mpedromogollon-source/muebles/README.md

# Cálculo estructural: closet con maleteros sobre PTR de 30 x 30 mm

Modelo tridimensional de elementos finitos del closet de `datos/origen/closet_pedido_mx.skp`
con la modificación de dos PTR de 30 x 30 mm (3 x 3 cm) bajo los maleteros, apoyados en las torres.
Revisión 2: la primera versión suponía un PTR de 3" x 3"; esta la sustituye.

La memoria de cálculo completa está en
[`resultados/memoria_calculo_closet_PTR.pdf`](resultados/memoria_calculo_closet_PTR.pdf).

## Contenido

| Ruta | Qué hace |
|---|---|
| `datos/origen/` | Archivo SketchUp y diagrama de corte originales |
| `herramientas/skp_lector.py` | Lee el formato binario de SketchUp 2021+ y exporta las piezas visibles con sus medidas reales |
| `datos/piezas_closet.json` | Piezas del conjunto armado (coinciden con las 89 del diagrama de corte) |
| `modelo/parametros.py` | Materiales, cargas, rigideces y criterios adoptados |
| `modelo/perfiles.py` | Propiedades del PTR cuadrado por calibre |
| `modelo/modelo_fe.py` | Modelo OpenSeesPy: tableros como cascarones, PTR como vigas, uniones y contactos |
| `modelo/analisis.py` | Combinaciones de carga y posproceso |
| `modelo/ejecutar.py` | Corre todas las variantes y guarda `resultados/resultados.json` |
| `modelo/verificaciones.py` | Revisiones AISC 360-16 (PTR) y EN 1995 (tablero, uniones), volteo y anclaje |
| `modelo/pandeo.py` | Análisis con no linealidad geométrica (estabilidad) |
| `modelo/figuras.py`, `modelo/memoria.py` | Figuras y memoria en PDF |

## Cómo reproducir

```bash
pip install openseespy numpy matplotlib reportlab pillow
python herramientas/skp_lector.py datos/origen/closet_pedido_mx.skp --xmin 4700 --xmax 7800 \
    --salida datos/piezas_closet.json
python modelo/ejecutar.py          # ~15 min con 4 núcleos
python modelo/pandeo.py            # análisis no lineal, tarda bastante más
python modelo/verificaciones.py
python modelo/figuras.py
python modelo/memoria.py
```

`resultados/resultados.pkl` (campos de desplazamiento para figuras) no se versiona; lo
genera `ejecutar.py`.

## Resultado en breve

* El PTR de 30 x 30 mm trabaja como viga continua sobre los cuatro laterales de las torres. Con
  apoyos firmes necesitaría la mitad de su resistencia a flexión; el problema del proyecto es que
  uno de esos apoyos, el lateral interior de cada torre ("lateral aire"), no llega al piso
  (hueco de 205 mm) y cede porque cuelga de tornillos al tablero trasero.
* Tal como está diseñado, el mueble no cumple con ningún calibre (18, 16 o 14): la flecha del
  frente queda entre L/101 y L/110 a largo plazo, el tablero trasero de las torres y sus uniones
  se sobrecargan y los laterales exteriores se pandean con la carga sostenida.
* Solución recomendada: relleno de 15 mm (585 x 205 mm) bajo cada lateral aire, entrepaño fijo
  intermedio a 1120 mm en cada torre, suplemento de canto de 15 mm en la cara de cada lateral
  aire que da al hueco central, tubo cal. 14 fijado con pijas a cada 150 mm, maleteros unidos con
  tornillos pasantes M6 y anclaje al muro. La flecha del tramo central queda entre L/307 y L/322
  según la rigidez real de las pijas; el cal. 16 y el cal. 18 no la cumplen.
