mpedromogollon-source/muebles/(list of files, cad)

Other CAD files:
datos/origen/closet_pedido_mx.skp
