mpedromogollon-source/muebles/resultados/memoria_calculo_closet_PTR.pdf

Memoria de cálculo estructural. Closet con maleteros sobre PTR de 30 x 30 mm. Revisión 2 | Página 1

# Memoria de cálculo estructural

### Closet con tres maleteros apoyados en dos PTR de 30 x 30 mm sobre dos torres de melamina

Archivo de proyecto: closet pedido mx.skp (SketchUp 2023) y diagrama de corte del 15/08/2025. Fecha del cálculo: 12/10/2026. Revisión 2: el PTR es de 30 x 30 mm (3 x 3 cm); esta revisión sustituye a la anterior, que suponía un PTR de 3" x 3".

### Resumen ejecutivo

- El PTR de 30 x 30 mm trabaja como viga continua sobre los cuatro laterales de las torres (los exteriores y los

laterales aire). Con apoyos firmes necesitaría 0.19 kN·m, el 51% de su resistencia de 0.37 kN·m, y su flecha de servicio sería de unos 5 mm en el tramo central: la sección alcanza si los apoyos no ceden. Si el lateral aire no lo apoyara, como viga simple de 2865 mm necesitaría 1.01 kN·m (2.7 veces su resistencia). En el modelo, con la rigidez final de la melamina, el momento máximo del proyecto es 0.23 kN·m y la interacción con el axial llega al 66%.
- El proyecto tal cual no cumple. Flecha del PTR frontal 10.9 mm instantánea y 27.2 mm a largo plazo (L/106 en el

tramo exterior, límite L/300); tablero trasero de la torre con índice 1.58; uniones al 163% de su capacidad; tornillos entre maleteros al 128%; desplome sin anclaje de 13.8 mm instantáneo y 39.5 mm a largo plazo; y el lateral exterior se abomba 35 mm con la carga sostenida. Cambiar el calibre del tubo (18, 16 o 14) no lo resuelve: la flecha queda entre L/101 y L/110.
- La causa es el apoyo, no el tubo: el lateral interior de cada torre ("lateral aire", 900 mm) no llega al piso; entre la

cubierta de cajones y su canto inferior hay un hueco abierto de 205 mm. Ese lateral recibe la mayor parte de la carga del PTR frontal (0.61 kN en servicio, contra 0.37 kN del lateral exterior), cede porque cuelga de tornillos al tablero trasero y lo sobrecarga.
- Con un relleno de 15 mm (585 x 205 mm) bajo cada lateral aire, el lateral aire queda como apoyo firme y todas

las revisiones de resistencia cumplen: tableros al 55%, uniones al 44%, tubo cal. 16 al 42% aun sin acción conjunta con los maleteros (36% en cal. 14). La flecha del tramo central depende de cuánto cortante transmitan las pijas entre el tubo y los tableros. Con tubo cal. 14 y pijas a cada 150 mm cumple: L/307 con una rigidez baja de la pija, con la que todas las pijas quedan dentro de su capacidad (88%), y L/322 con la rigidez de EN 1995. Solo si la fijación no transmitiera nada quedaría en L/282, un 7% sobre el límite de apariencia. Con cal. 16 la flecha no cumple en ningún caso (L/252 a L/288).
- Estabilidad. El canto frontal de los laterales queda libre 870 mm en el compartimento superior. En el proyecto, con la

carga sostenida, el lateral exterior se abomba 35 mm. Solo con el relleno baja a 3.9 mm, todavía por encima del límite visual de 2.9 mm, y el lateral aire pierde rigidez cerca de λ = 1.4 a largo plazo. Con relleno y un entrepaño fijo intermedio a 1120 mm en cada torre queda en 1.3 mm; el abombamiento crece de forma moderada (al final de la corrida su pendiente es 1.5 a 1.6 veces la inicial, contra 3.5 o más sin entrepaño) y no hay pérdida de estabilidad hasta más de λ = 3.1 a largo plazo y 4 a corto plazo.
- El apoyo del tubo sobre los cantos de 15 mm queda al límite: 0.94 de la resistencia con relleno; si además se

omiten los tornillos entre maleteros llega a 1.005, ligeramente por encima de la resistencia. Un suplemento de canto de 15 mm atornillado a la cara de cada lateral aire que da al hueco central, a ras de su canto superior, lo baja a 0.50.
- Sin anclaje, el mueble vacío se voltea con una aceleración horizontal de 0.18 g y cargado con 0.21 g. Hay que fijarlo al

muro: 0.93 kN por torre y hasta 0.22 kN por taquete de maletero con el coeficiente adoptado. El anclaje también limita el desplome en servicio.
- Las repisas de 15 mm cumplen resistencia; con carga de almacenamiento sostenida su flecha diferida supera L/200.

Es un tema de apariencia que se corrige con un piso de maletero de 20 mm o más y un refuerzo frontal en los entrepaños de torre.

Memoria de cálculo estructural. Closet con maleteros sobre PTR de 30 x 30 mm. Revisión 2 | Página 2

### Resumen de verificaciones

Verificación | Proyecto | Con relleno | Relleno + entrepaño

Recomendada:
relleno +
entrepaño, cal.
14, pijas a 150
mm

Criterio

PTR: flexión con axial (AISC H1) | 0.66 | 0.40 | 0.40 | 0.36 | ≤ 1.0
PTR: cortante y paredes | 0.10 | 0.08 | 0.08 | 0.07 | ≤ 1.0

PTR frontal: flecha a largo plazo,
tramo que gobierna | L/106 | L/306 | L/305 | L/307 | ≤ L/300
Apoyo del PTR en canto de 15 mm σ/fc,d | 0.67 | 0.94 | 0.94 | 0.93 | ≤ 1.0

Apoyo con suplemento de canto en el
lateral aire | 0.47 | 0.47 | 0.47 | 0.47 | ≤ 1.0
Tableros: índice de esfuerzo máximo | 1.58 | 0.55 | 0.55 | 0.52 | ≤ 1.0
Uniones: demanda / confirmat típicos | 1.63 | 0.44 | 0.44 | 0.44 | ≤ 1.0
Tornillos entre maleteros | 1.28 | 0.49 | 0.49 | 0.51 | ≤ 1.0
Estabilidad, corto plazo: λ límite | > 3.156 | > 2.031 | > 4.0 | > 4.0 | ≥ 3
Estabilidad, largo plazo: λ límite | > 1.75 | > 1.406 | > 3.125 | > 3.125 | ≥ 3

Abombamiento de laterales con carga

sostenida | 34.7 mm | 3.9 mm | 1.3 mm | 1.3 mm | ≤ 870/300 = 2.9
| | | | | mm

Desplome superior de maleteros a

largo plazo, sin anclaje | 39.5 mm | 10.6 mm | 10.6 mm | 10.9 mm | < 5 mm (se
| | | | | resuelve con el
| | | | | anclaje)
Repisas: flecha diferida / (L/200) | 4.27 | 2.36 | 2.36 | 2.36 | ≤ 1.0

Volteo sin anclaje: aceleración que lo
inicia | 0.18 g | 0.18 g | 0.18 g | 0.18 g | anclar al muro

Verde: cumple con holgura. Amarillo: al límite o requiere atención. Rojo: no cumple. Tubo cal. 16 y fijación rígida del PTR salvo indicación; la fijación rígida es una idealización que las pijas no alcanzan (sección 6.6). "-" indica caso no analizado. La estabilidad de la solución recomendada se toma de la variante con relleno y entrepaño.

Memoria de cálculo estructural. Closet con maleteros sobre PTR de 30 x 30 mm. Revisión 2 | Página 3

## 1. Objeto y alcance

Se verifica la estructura del closet con la modificación indicada por el cliente: dos PTR de 30 x 30 mm colocados bajo los maleteros, a todo lo largo, apoyados sobre las dos torres (módulos verticales). Se revisan el PTR, los tableros de melamina, las uniones atornilladas, el apoyo del PTR sobre los cantos de los tableros, la estabilidad de los laterales, las deformaciones y el volteo. El cálculo se hace con un modelo tridimensional de elementos finitos construido a partir de la geometría real del archivo SketchUp, complementado con verificaciones analíticas.

## 2. Descripción del mueble

La geometría se extrajo directamente del archivo .skp (formato SketchUp 2023, árbol binario de componentes) con un lector propio. Las 89 piezas de melamina de 15 mm extraídas coinciden una a una con el diagrama de corte (22.41 m² de tablero, 6 hojas de 2440 x 1830 mm). Medidas principales:

Elemento | Medidas (mm) | Composición
Conjunto | 2880 de frente x 600 de fondo; altura 2440 en
el proyecto, 2470 con los PTR bajo maleteros

Dos torres en los extremos, hueco central de 1640 mm, tres maleteros arriba

Torre (x2) | 620 x 600 x 1570 (zócalo 100 + casco 1470)

Lateral exterior 1455, trasero 15 mm de 605 x 1455, piso, 2 cajones, cubierta 605 x 585 a 450, entrepaño con amarres a 685, travesaños superiores 590 x 100, puerta 618 x 897

Lado interior de torre Panel inferior 585 x 335 (z 115 a 450); lateral aire 585 x 900 (z 670 a 1570)

Hueco abierto de 205 mm entre z 465 y 670: el lateral aire no tiene apoyo directo hacia el piso

Maletero (x3) | 960 x 870 x 600

Costados de altura completa, piso y techo entre costados, dos tiras traseras de 200 mm, travesaño frontal 930 x 100, dos puertas 478 x 855

PTR (x2) | 30 x 30, L = 2880 | Uno a paño frontal y otro a paño trasero, bajo los costados y el piso
de los maleteros, apoyados en la parte superior de las torres

Nombres usados en este documento y su correspondencia con el diagrama de corte (letras de pieza y nombre de componente en SketchUp):

Nombre en la memoria | Letras en el diagrama de corte | Componente SketchUp
Lateral exterior | C, D | ESPCL-LD-02
Lateral aire | H, I | lateral aire
Trasero 15 mm | A, B | fondo 15mm
Piso de torre | Q, R | ESPCL-PI-02
Travesaño superior de torre | AC, AD | ESPCL-T-01
Panel inferior interior | AI, AJ | REPIZA@1#8
Cubierta de cajones | W, X | REPIZA@1#9
Travesaño bajo cubierta | AA, AB | REPIZA@1#7
Entrepaño (tope) | Y, Z | PTRSOP024-TO
Amarre trasero bajo entrepaño | AF, AH | PTRSOP022
Amarre frontal bajo entrepaño | AE, AG | PTRSOP0-125
Zócalo frontal | S, T | ZOCALO-ALANTE-02
Zócalo trasero | U, V | ZOCALO-ATRAS-01
Zócalo lateral | AU, AV | ZOCALO-DE-03
Zócalo lateral | AW, AX | ZOCALO-IZ-04
Piso de maletero | E | MALEST-MA
Techo de maletero | F | MALEST-MR
Costado de maletero | M | MALEST-MI
Costado de maletero | L | MALEST-MD
Tira trasera de maletero | P | MALEST-RI
Tira trasera de maletero | O | MALEST-RD

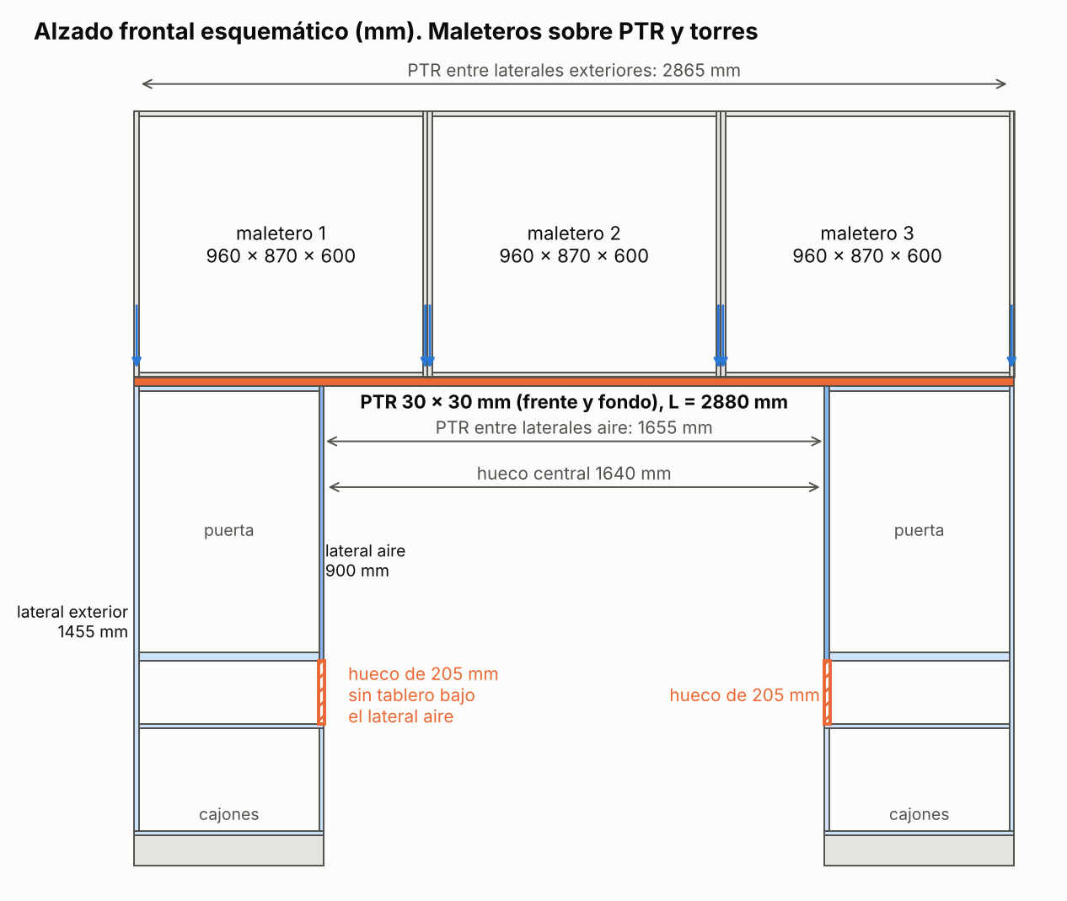
[picture p1: figure]

Memoria de cálculo estructural. Closet con maleteros sobre PTR de 30 x 30 mm. Revisión 2 | Página 4
Nombre en la memoria | Letras en el diagrama de corte | Componente SketchUp
Travesaño frontal de maletero | G | REPIZA@1#1
Relleno propuesto | nuevo | relleno bajo lateral aire

Figura 1. Alzado frontal esquemático. En naranja rayado, el hueco de 205 mm bajo cada lateral aire.

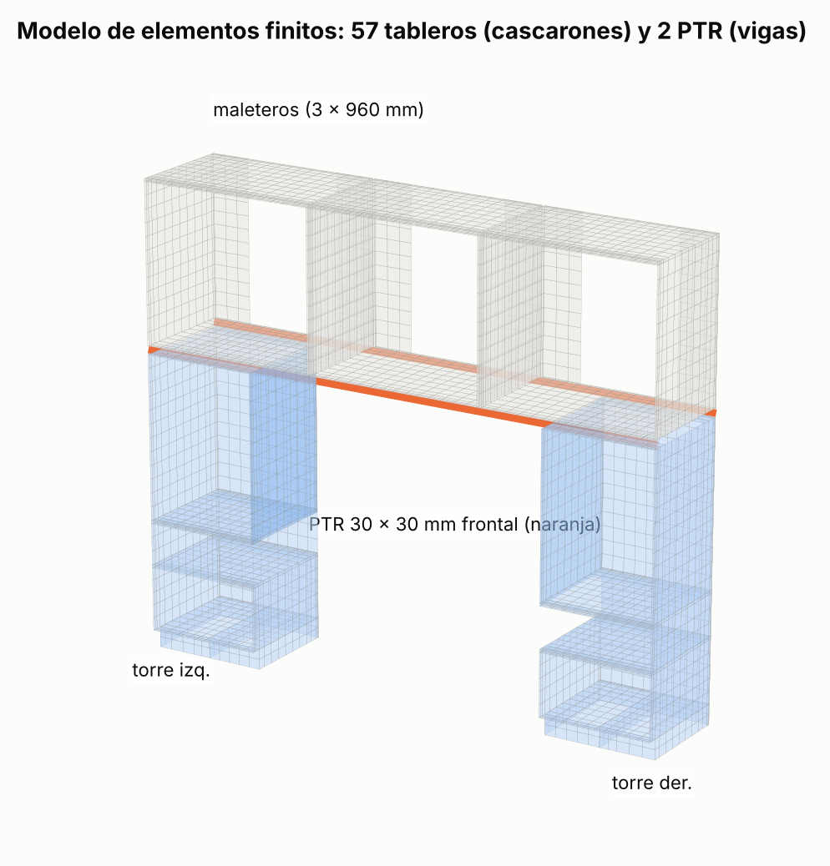
[picture p2: figure]

Memoria de cálculo estructural. Closet con maleteros sobre PTR de 30 x 30 mm. Revisión 2 | Página 5

Figura 2. Modelo de elementos finitos (tableros en su plano medio; PTR en naranja).

## 3. Materiales y propiedades adoptadas

La melamina comercial es tablero de partículas de uso interior (tipo EN 312 P2), que no es un grado estructural. Se adoptaron valores reducidos a partir de EN 12369-1 (P4, 13 a 20 mm) escalados al mínimo de P2 y los factores de duración de carga y fluencia de EN 1995-1-1 para tablero de partículas en clase de servicio 1.

Propiedad | Valor | Fuente o criterio
Tablero: espesor, densidad | 15 mm, 680 kg/m³ | Diagrama de corte; densidad típica de MDP
Módulo de elasticidad medio E, ν | 2000 MPa, 0.25 | Mínimo P2 (1600) llevado a valor medio

f

m,k / ft,k / fc,k / fv,k | 10.0 / 6.5 / 8.5 / 4.8 MPa | EN 12369-1 P4 escalado a P2

k

mod permanente / largo plazo / corto | 0.3 / 0.45 / 0.85 | EN 1995-1-1 tabla 3.1

k

def, γM | 2.25, 1.3 | EN 1995-1-1 tablas 3.2 y 2.3
Acero PTR: E, F y | 200000 MPa, 250 MPa | F y conservador; un ASTM A500 Gr. B tiene 317 MPa
PTR de 30 x 30 mm cal. 18 | t = 1.21 mm nominal, 1.13 mm de diseño; A = 1.27 cm²; I = 1.74 cm⁴; Z = 1.36 cm³; 1.07 kg/m | Espesor de diseño 0.93 t (AISC B4.2); radio exterior 2t

Memoria de cálculo estructural. Closet con maleteros sobre PTR de 30 x 30 mm. Revisión 2 | Página 6
Propiedad | Valor | Fuente o criterio
PTR de 30 x 30 mm cal. 16 | t = 1.52 mm nominal, 1.41 mm de diseño; A = 1.56 cm²; I = 2.09 cm⁴; Z = 1.66 cm³; 1.31 kg/m | Espesor de diseño 0.93 t (AISC B4.2); radio exterior 2t (caso base)

PTR de 30 x 30 mm cal. 14

t = 1.90 mm nominal, 1.76 mm de diseño; A = 1.91 cm²; I = 2.49 cm⁴; Z = 1.99 cm³; 1.60 kg/m

Espesor de diseño 0.93 t (AISC B4.2); radio exterior 2t

Confirmat 7 x 50 en melamina 15 mm | F

v,k = 1.0 kN; Fax,k = 0.8 kN

Valores adoptados, verificar con el fabricante. Se usan para la tracción de los tornillos de unión entre maleteros

Tornillo pasante M6 entre dos tableros de
15 mm | F
v,d = 314 N por plano | EN 1995-1-1 8.2.2 (Johansen), kmod = 0.45

Pija de 4.8 mm a través de la pared del
tubo en 15 mm de tablero | F

v,d = 283 N; K
ser
= 7401 N/mm | EN 1995-1-1 8.2.3 (placa de acero delgada) y
7.1 (acero contra tablero)

## 4. Cargas y combinaciones

Caso | Descripción | Valor
G | Peso propio de tableros (+5 % por cubrecanto y herrajes), puertas, cajones,
| correderas y PTR | 2.51 kN en total (256 kg)
Q maleteros | Contenido sobre el piso de cada maletero | 1.5 kN/m² (150 kg/m²)
Q torres | Cubierta de cajones y entrepaño; contenido de cajones | 1.5 kN/m²; 25 kg por cajón
Q barra | Barra de colgar supuesta en el hueco central, fijada a los laterales aire a 1450
| mm | 0.40 kN/m sobre 1.64 m
H | Fuerza horizontal hacia el frente para dimensionar anclajes | 0.5 (G + ψ2 Q)

Carga total en servicio G + Q = 8.82 kN. Combinaciones: para el acero, AISC 360-16 con ASCE 7 (1.2G + 1.6Q y 1.4G). Para tableros y uniones, EN 1990 (1.35G + 1.5Q con kmod de largo plazo y 1.35G con kmod permanente). Servicio: G + Q instantánea y G + ψ2
Q con ψ2

= 0.8 (almacenamiento) para la deformación diferida, calculada con E/(1 + kdef) en los tableros, con la rigidez de las uniones entre tableros dividida entre 1 + 2kdef (EN 1995-1-1 2.3.2.2, materiales con la misma fluencia) y la de las pijas acero contra tablero entre 1 + kdef. Anclaje: G + ψ2

Q + H.

## 5. Modelo de elementos finitos

El modelo se construyó en OpenSeesPy. Las decisiones de idealización son las siguientes:
- Cada tablero es un cascarón ShellMITC4 en su plano medio (5854 elementos de hasta 75 mm). Los cantos que llegan

a otro tablero se llevan al plano medio de éste.
- Cada tablero tiene nodos propios. Las uniones son resortes en traslación sin momento (bisagra lineal): 10 N/mm por

mm de unión en corte y tracción (tornillería), y 150 N/mm por mm en compresión cuando un canto apoya directamente en una cara. Son 966 resortes de canto y 683 de cara (entrepaños sobre amarres y travesaños, y 4 tornillos entre maleteros contiguos).
- Los PTR de 30 x 30 mm son vigas elásticas 3D en su eje; los maleteros se elevan 30 mm. El contacto vertical con

torres y maleteros es solo a compresión (el mueble descansa sobre el PTR); en horizontal la fijación se supone rígida, y en la sección 6.6 se repite con pijas de rigidez realista. Se resuelve por Newton para cada combinación.
- Base del zócalo articulada en el piso. Puertas y cajones se aplican como cargas en el tablero que los soporta (bisagras

del lado del lateral aire en las torres).
- Controles: el peso del modelo coincide con el del despiece; las reacciones igualan la carga aplicada; los resultados son

simétricos entre torres; no quedan contactos en tracción.

Variantes analizadas, cada una a corto y largo plazo: proyecto con tubo cal. 18, 16 y 14; proyecto sin tornillos entre maleteros; relleno de 15 mm bajo cada lateral aire, con y sin tornillos entre maleteros; relleno más un entrepaño fijo intermedio a 1120 mm en cada torre, con tubo cal. 16 y cal. 18 y fijación rígida, y con fijación por pijas en cal. 16 y cal. 14 (rigidez de EN 1995 a cada 150 y 75 mm, y una rigidez menor a cada 150 mm como sensibilidad); y, como referencia, el proyecto con PTR de 3" x 3". Las variantes principales se revisan en estado último también con la rigidez final de la

Memoria de cálculo estructural. Closet con maleteros sobre PTR de 30 x 30 mm. Revisión 2 | Página 7

melamina, y se toma la envolvente. Además uniones diez veces más rígidas (sensibilidad, sección 6.1) y caso horizontal con anclajes al muro.

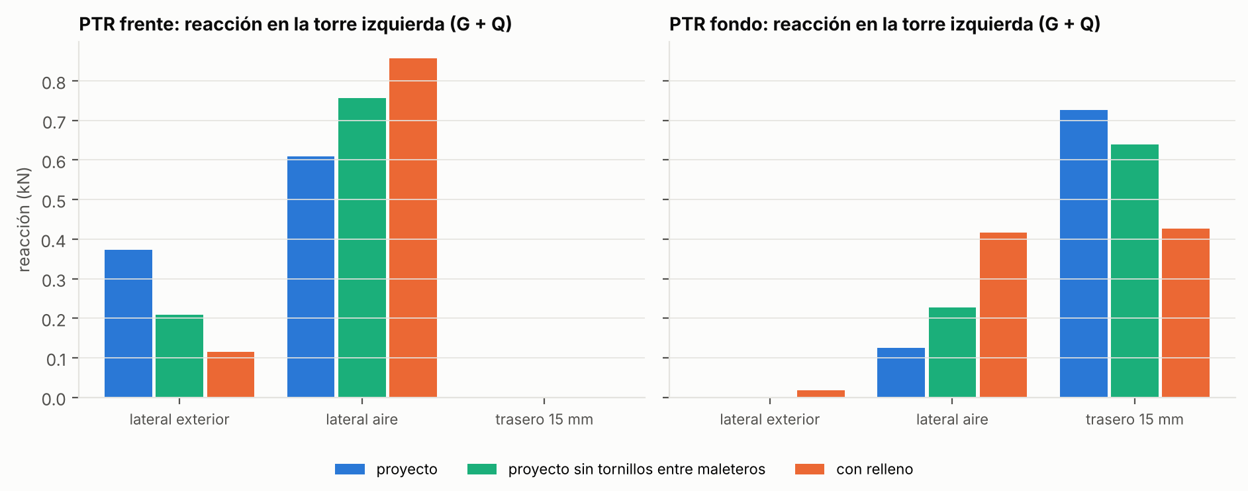
[picture p3: figure]

Memoria de cálculo estructural. Closet con maleteros sobre PTR de 30 x 30 mm. Revisión 2 | Página 8

## 6. Resultados

### 6.1 Cómo trabaja el conjunto y cómo llega la carga a las torres

El tubo de 30 x 30 mm se apoya en los cuatro laterales de las torres y comparte la carga con los maleteros, que son más rígidos que él y están fijados a él. Lo que decide el comportamiento es la rigidez de los apoyos. La figura 3 y la tabla muestran qué elemento de la torre recibe la reacción de cada PTR. En el proyecto, el lateral aire recibe la mayor parte del frente aunque no llega al piso; la pasa por tornillos al tablero trasero y por eso cede. El PTR trasero se apoya sobre todo en el canto del tablero trasero de 15 mm, que trabaja como muro. Con uniones diez veces más rígidas el reparto del PTR frontal apenas cambia (el lateral aire recibe 0.63 kN en lugar de 0.61 kN), pero el del trasero sí: el lateral aire pasa de 0.13 a 0.38 kN y el tablero trasero de 0.73 a 0.48 kN.

Figura 3. Reacción de cada PTR sobre los elementos de la torre izquierda (la derecha es simétrica), combinación G + Q.

PTR / elemento de la torre | Proyecto (kN) | Con relleno (kN) | Relleno + entrepaño (kN) | Proyecto sin tornillos entre maleteros (kN)
PTR frente: lateral exterior | 0.37 | 0.12 | 0.12 | 0.21
PTR frente: lateral aire | 0.61 | 0.86 | 0.86 | 0.76
PTR fondo: lateral exterior | 0.00 | 0.02 | 0.02 | 0.00
PTR fondo: lateral aire | 0.13 | 0.42 | 0.42 | 0.23
PTR fondo: trasero 15 mm | 0.73 | 0.43 | 0.43 | 0.64

### 6.2 PTR de 30 x 30 mm

Sección compacta en los tres calibres (b/t = 18.2 en cal. 16, λ
p

= 31.7). Resistencias de diseño AISC 360-16 (F7, G4 y J10) con espesor de diseño 0.93 t; como no se conoce el radio de esquina se usan b = h = B - 3t y k = 1.5t. La revisión de paredes compara la reacción del lateral exterior con la resistencia de extremo y la del lateral aire con la interior. Como el reparto de cargas entre el tubo y la melamina depende de la rigidez, la flexión se revisa con la rigidez instantánea y con la final, E/(1 + ψ2

k

def), según EN 1995-1-1 2.3.2.2; la tabla da la que gobierna. La fijación a los tableros induce un axial en el tubo, que se combina con la flexión según AISC H1-1; como el tubo está fijado a cada 150 mm o menos, su esbeltez a compresión es despreciable y P
c

= 0.9F
y

A.

Comprobación manual con la carga que los maleteros apoyan en el PTR frontal (2.83 kN en 1.2G + 1.6Q y 1.93 kN en G + Q), repartida a lo largo del tubo. Como viga continua sobre los cuatro laterales con apoyos firmes: Mu

= 0.19 kN·m y
flecha de servicio de 5.1 mm en el tramo central. Como viga simple de 2865 mm, si el lateral aire no apoyara: Mu

= WL/8 =
1.01 kN·m y 5WL³/384EI = 141 mm. El modelo con fijación rígida da 0.12 kN·m con rigidez instantánea: menos que la viga continua porque los maleteros, más rígidos que el tubo y fijados a él, toman parte de la carga. En el proyecto la flecha del modelo (10.9 mm respecto a los laterales exteriores) es mucho mayor que la de la viga continua porque el lateral aire cede: es un apoyo flexible.

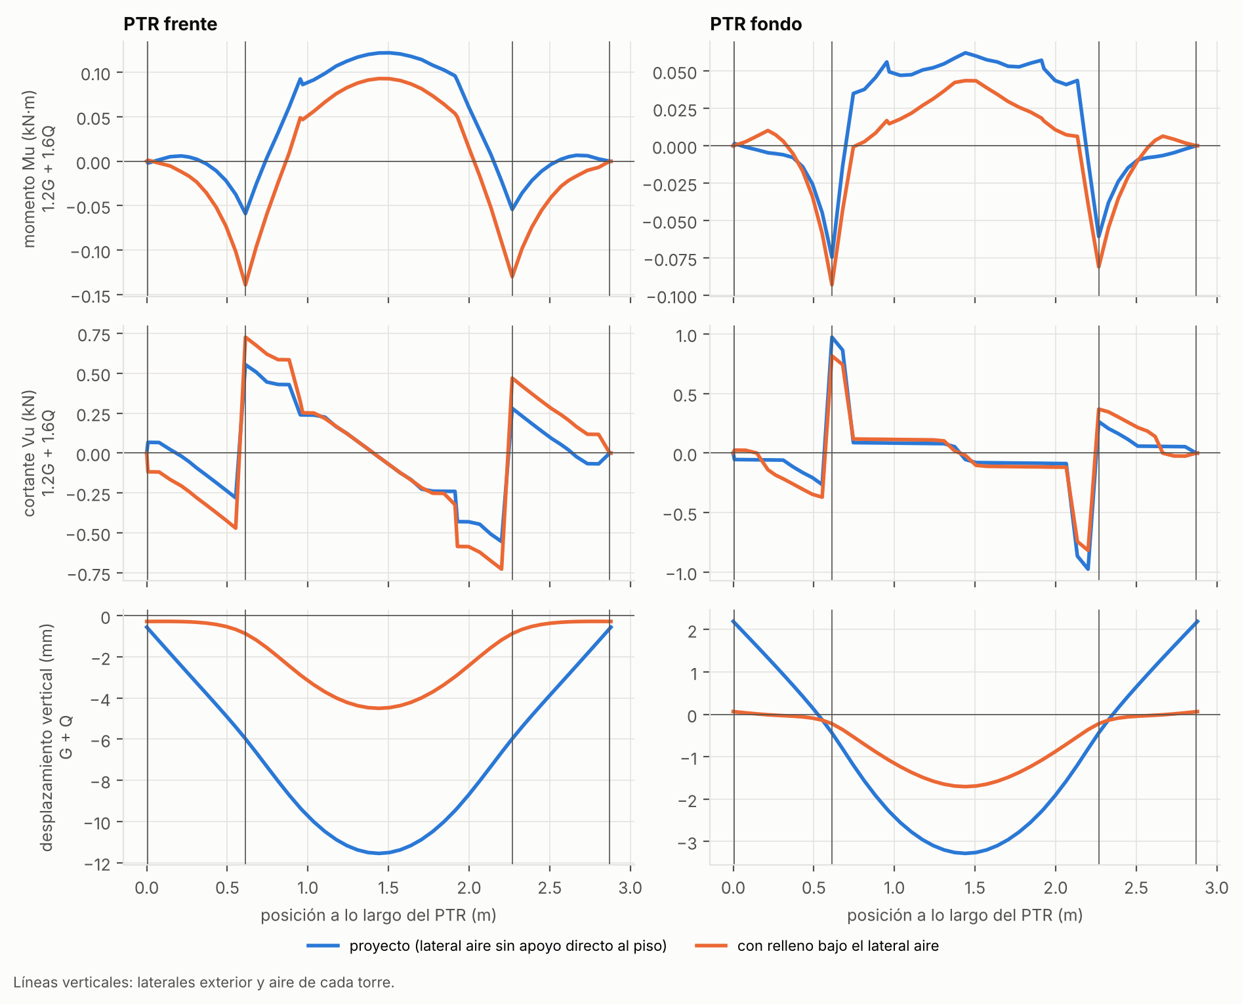
[picture p4: figure]

Memoria de cálculo estructural. Closet con maleteros sobre PTR de 30 x 30 mm. Revisión 2 | Página 9

Figura 4. Momento y cortante últimos (1.2G + 1.6Q, rigidez instantánea) y desplazamiento en servicio (G + Q) a lo largo de cada PTR.

Variante | Perfil | φMn
| | (kN·m) | Flexión con
| | | axial, H1
| | | (rigidez) | V
| | | | u /φV
n
| | | | | Flecha
| | | | | G+Q
| | | | | (mm) | Flecha
| | | | | | largo plazo
| | | | | | (mm) | Relación
| | | | | | | (tramo)
Proyecto | 30x30 cal. 16 | 0.37 | 0.66 (final) | 0.10 | 10.9 | 27.2 | L/106 (exterior)
Proyecto, cal. 18 | 30x30 cal. 18 | 0.31 | 0.72 (final) | 0.12 | 11.4 | 28.3 | L/101 (exterior)
Proyecto, cal. 14 | 30x30 cal. 14 | 0.45 | 0.60 (final) | 0.08 | 10.6 | 26.1 | L/110 (exterior)

Proyecto sin tornillos entre
maleteros | 30x30 cal. 16 | 0.37 | 0.77 (final) | 0.08 | 13.3 | 32.0 | L/89 (exterior)
Con relleno | 30x30 cal. 16 | 0.37 | 0.40
| | | (instantánea) | 0.08 | 3.6 | 5.4 | L/306 (central)

Con relleno, sin tornillos entre

maleteros | 30x30 cal. 16 | 0.37 | 0.43
| | | (instantánea) | 0.08 | 3.9 | 5.7 | L/290 (central)
Relleno + entrepaño | 30x30 cal. 16 | 0.37 | 0.40
| | | (instantánea) | 0.08 | 3.6 | 5.4 | L/305 (central)
Relleno + entrepaño, cal. 18 | 30x30 cal. 18 | 0.31 | 0.49 (final) | 0.10 | 4.0 | 6.1 | L/273 (central)

Relleno + entrepaño, cal. 16,

sin acción conjunta | 30x30 cal. 16 | 0.37 | 0.42
(instantánea) | 0.08 | 5.0 | 6.6 | L/252 (central)

Relleno + entrepaño, cal. 16,

pijas a 150 mm, rigidez baja | 30x30 cal. 16 | 0.37 | 0.42
(instantánea) | 0.08 | 4.4 | 6.0 | L/274 (central)

Relleno + entrepaño, cal. 16,
pijas a 150 mm, rigidez EN
1995
30x30 cal. 16 | 0.37 | 0.41
(instantánea) | 0.08 | 4.0 | 5.7 | L/288 (central)

Memoria de cálculo estructural. Closet con maleteros sobre PTR de 30 x 30 mm. Revisión 2 | Página 10
Variante | Perfil | φMn (kN·m)

Flexión con
axial, H1
(rigidez)

V
u

/φV
n

Flecha
G+Q
(mm)

Flecha
largo plazo
(mm)

Relación
(tramo)

Relleno + entrepaño, cal. 14,

sin acción conjunta | 30x30 cal. 14 | 0.45 | 0.36
| | (instantánea) | 0.07 | 4.4 | 5.9 | L/282 (central)

Recomendada: relleno +
entrepaño, cal. 14, pijas a 150
mm
30x30 cal. 14 | 0.45 | 0.36 (final) | 0.07 | 3.9 | 5.4 | L/307 (central)

Relleno + entrepaño, cal. 14, pijas a 150 mm, rigidez EN 1995

30x30 cal. 14 | 0.45 | 0.35
| | (instantánea) | 0.07 | 3.6 | 5.1 | L/322 (central)

Proyecto, PTR de 3" x 3" (76.2

mm), comparación | 3"x3" cal. 14 | 2.78 | 0.25
(instantánea) | 0.03 | 4.1 | 5.4 | L/529 (exterior)

Flecha del PTR frontal respecto a dos cuerdas: entre laterales exteriores (L = 2865 mm, límite 9.6 mm) y entre laterales aire (tramo central, L = 1655 mm, límite 5.5 mm); se informa la que gobierna. El PTR de 3" x 3" se incluye solo como comparación con la revisión anterior.

### 6.3 Deformaciones

Elemento | Variante | Instantánea
| | G+Q (mm) | Largo plazo
| | | (mm) | Límite (mm) | Relación
PTR frente, tramo exterior (L = 2865 mm) | Proyecto | 10.94 | 27.16 | 9.6 (L/300) | L/106
PTR frente, tramo central (L = 1655 mm) | Proyecto | 5.57 | 11.68 | 5.5 (L/300) | L/142
PTR fondo, tramo exterior (L = 2865 mm) | Proyecto | 5.44 | 10.81 | 9.6 (L/300) | L/265
PTR fondo, tramo central (L = 1655 mm) | Proyecto | 2.84 | 5.22 | 5.5 (L/300) | L/317
PTR frente, tramo exterior (L = 2865 mm) | Con relleno | 4.22 | 7.79 | 9.6 (L/300) | L/368
PTR frente, tramo central (L = 1655 mm) | Con relleno | 3.63 | 5.42 | 5.5 (L/300) | L/306
PTR fondo, tramo exterior (L = 2865 mm) | Con relleno | 1.77 | 3.57 | 9.6 (L/300) | L/804
PTR fondo, tramo central (L = 1655 mm) | Con relleno | 1.49 | 2.57 | 5.5 (L/300) | L/644
PTR frente, tramo exterior (L = 2865 mm) | Relleno + entrepaño | 4.23 | 7.81 | 9.6 (L/300) | L/367
PTR frente, tramo central (L = 1655 mm) | Relleno + entrepaño | 3.63 | 5.42 | 5.5 (L/300) | L/305
PTR fondo, tramo exterior (L = 2865 mm) | Relleno + entrepaño | 1.77 | 3.57 | 9.6 (L/300) | L/803
PTR fondo, tramo central (L = 1655 mm) | Relleno + entrepaño | 1.49 | 2.57 | 5.5 (L/300) | L/643
PTR frente, tramo exterior (L = 2865 mm) | Recomendada: relleno +
| entrepaño, cal. 14, pijas
| a 150 mm | 4.58 | 8.01 | 9.6 (L/300) | L/358

PTR frente, tramo central (L = 1655 mm)

Recomendada: relleno +
entrepaño, cal. 14, pijas
a 150 mm
3.92 | 5.39 | 5.5 (L/300) | L/307

PTR fondo, tramo exterior (L = 2865 mm)

Recomendada: relleno +
entrepaño, cal. 14, pijas
a 150 mm
2.02 | 3.70 | 9.6 (L/300) | L/774

PTR fondo, tramo central (L = 1655 mm)

Recomendada: relleno +
entrepaño, cal. 14, pijas
a 150 mm
| | 1.73 | 2.71 | 5.5 (L/300) | L/611
Entrepaño (tope) (L = 605) | Proyecto | 4.36 | 12.90 | 3.0 (L/200) | L/47
Piso de maletero (maletero 2) (L = 570) | Proyecto | 2.16 | 6.53 | 2.9 (L/200) | L/87
Cubierta de cajones (L = 605) | Proyecto | 1.73 | 5.64 | 3.0 (L/200) | L/107
Piso de maletero (maletero 2) (L = 570) | Con relleno | 2.28 | 6.74 | 2.9 (L/200) | L/85
Entrepaño (tope) (L = 605) | Con relleno | 1.75 | 6.02 | 3.0 (L/200) | L/100
Cubierta de cajones (L = 605) | Con relleno | 1.68 | 5.43 | 3.0 (L/200) | L/111
Desplome hacia el frente en la parte alta de los maleteros, sin anclaje al muro: 13.8 mm instantáneo en el proyecto y 3.9 mm con relleno; con la fluencia llega a 39.5 y 10.6 mm. Proviene de que el frente baja más que el fondo y gira los maleteros; el anclaje superior al muro lo restringe, así que es necesario también en servicio. En el proyecto la flecha

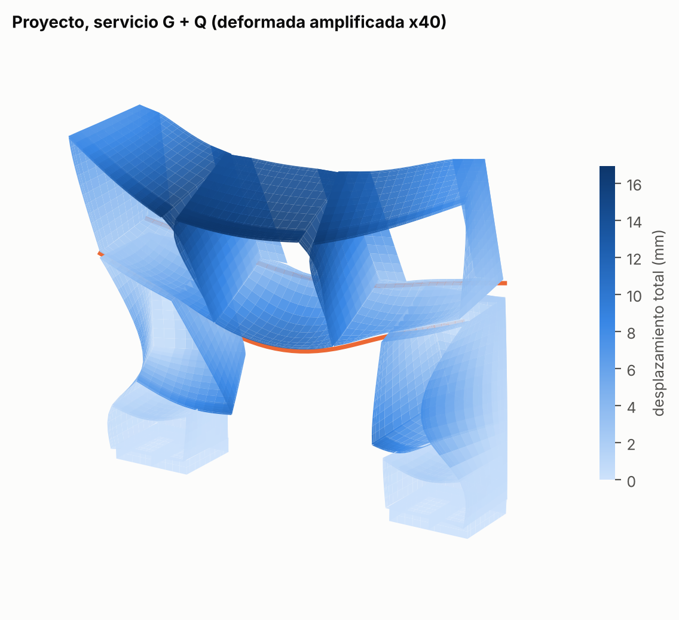
[picture p5: figure]

Memoria de cálculo estructural. Closet con maleteros sobre PTR de 30 x 30 mm. Revisión 2 | Página 11

diferida del entrepaño (tope) (12.9 mm, L/47) es más del doble que con relleno (6.0 mm): la diferencia es la carga que le cuelga el lateral aire. Con relleno las repisas cumplen resistencia, pero su flecha diferida con 1.2 kN/m² sostenidos excede L/200 (hasta 2.4 veces el límite). En el piso de maletero, que trabaja de frente a fondo entre los dos PTR, eso se corrige con un piso de 20 mm o más (con la flecha proporcional a 1/t³, 25 mm la dejan en la mitad del límite) o con un apoyo intermedio a media profundidad, que habría que verificar; en los entrepaños de torre, con un refuerzo frontal.

Figura 5. Deformada del proyecto en servicio, amplificada 40 veces.

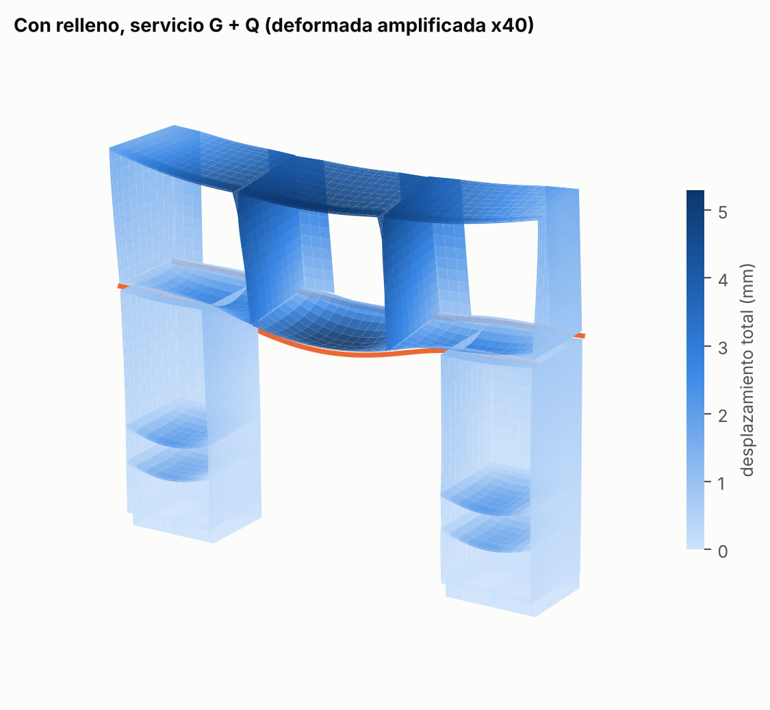
[picture p6: figure]

Memoria de cálculo estructural. Closet con maleteros sobre PTR de 30 x 30 mm. Revisión 2 | Página 12

Figura 6. Deformada con relleno bajo el lateral aire, misma escala de amplificación.

### 6.4 Esfuerzos en tableros

Índice de esfuerzo = esfuerzo de membrana / resistencia + esfuerzo de flexión / fm,d, por dirección y en cortante. Se informa el valor promediado en un radio de 75 mm (representativo) y el pico puntual, que aparece en esquinas de líneas de unión donde el modelo concentra fuerzas en un nodo.

Tablero | Variante y combinación | Pico puntual | Índice promediado
Trasero 15 mm | Proyecto, 1.35G+1.5Q | 2.99 | 1.58
Lateral exterior | Proyecto, 1.35G+1.5Q | 1.26 | 1.03
Amarre frontal bajo entrepaño | Proyecto, 1.35G+1.5Q | 0.56 | 0.55
Trasero 15 mm | Proyecto sin tornillos entre maleteros,
| 1.35G+1.5Q | 3.46 | 1.83
Lateral exterior | Proyecto sin tornillos entre maleteros,
| 1.35G+1.5Q | 1.42 | 1.16
Piso de maletero (maletero 2) | Proyecto sin tornillos entre maleteros,
| 1.35G+1.5Q | 0.68 | 0.56
Piso de maletero (maletero 1) | Con relleno, 1.35G+1.5Q | 0.57 | 0.55
Amarre frontal bajo entrepaño | Con relleno, 1.35G+1.5Q | 0.52 | 0.51
Travesaño bajo cubierta | Con relleno, 1.35G+1.5Q | 0.52 | 0.50
Piso de maletero (maletero 1) | Relleno + entrepaño, 1.35G+1.5Q | 0.57 | 0.55
Amarre frontal bajo entrepaño | Relleno + entrepaño, 1.35G+1.5Q | 0.52 | 0.51
Travesaño bajo cubierta | Relleno + entrepaño, 1.35G+1.5Q | 0.52 | 0.50
El máximo del proyecto está en el tablero trasero de la torre junto al canto inferior del lateral aire (índice 1.58 promediado, 2.99 puntual): ahí entra en el trasero la carga que cuelga del lateral aire. Con el relleno esa concentración desaparece.

Memoria de cálculo estructural. Closet con maleteros sobre PTR de 30 x 30 mm. Revisión 2 | Página 13

### 6.5 Uniones atornilladas

Capacidad de diseño por confirmat (kmod = 0.45): corte 346 N, extracción 277 N. La demanda de cada unión es la suma de tracciones (extracción) y cortantes del modelo; la compresión de canto contra cara no demanda al conector. Se calcula el número necesario con interacción cuadrática y un factor de reparto desigual de 1.25, y se compara con la cantidad típica (uno a 50 mm de cada extremo y separación de 200 mm).

Unión (pieza de canto contra pieza de cara) | L
| (mm) | Tracción
| | (N) | Cortante
| | | (N) | Conectores
| | | | necesarios | Conectores
| | | | | típicos | Separación
| | | | | | local máx.
| | | | | | (mm)
Proyecto: Cubierta de cajones contra Trasero 15 mm | 570 | 1424 | 291 | 7 | 4 | 69
Proyecto: Lateral aire contra Trasero 15 mm | 885 | 398 | 1804 | 7 | 5 | 73
Proyecto: Entrepaño (tope) contra Trasero 15 mm | 570 | 1098 | 302 | 6 | 4 | 106
Proyecto: Trasero 15 mm contra Lateral exterior | 1422 | 79 | 2680 | 10 | 8 | 173
Con relleno: Zócalo trasero contra Piso de torre | 605 | 0 | 487 | 2 | 4 | 421

Con relleno: Trasero 15 mm contra Lateral
exterior | 1422 | 31 | 941 | 4 | 8 | 480
Con relleno: Trasero 15 mm contra Piso de torre | 605 | 0 | 449 | 2 | 4 | 444
Con relleno: Lateral aire contra Trasero 15 mm | 885 | 19 | 534 | 2 | 5 | 405

Relleno + entrepaño: Zócalo trasero contra Piso
de torre | 605 | 0 | 490 | 2 | 4 | 419

Relleno + entrepaño: Trasero 15 mm contra
Lateral exterior | 1422 | 31 | 943 | 4 | 8 | 479

Relleno + entrepaño: Trasero 15 mm contra
Piso de torre | 605 | 0 | 452 | 2 | 4 | 442

Relleno + entrepaño: Lateral aire contra Trasero
15 mm | 885 | 18 | 529 | 2 | 5 | 406

### 6.6 Tornillos entre maleteros y fijación del PTR

El modelo supone cuatro tornillos de unión por cada costado común entre maleteros contiguos, cerca de las esquinas. Como unen cara con cara dos costados de 15 mm, deben ser tornillos pasantes de unión de módulos (M6 con casquillo o tuerca), no confirmat. Solo la tracción carga al tornillo; en compresión los costados se apoyan entre sí. La interacción se calcula tornillo por tornillo con 1.35G + 1.5Q, envolvente de rigidez instantánea y final, con 314 N en cortante (EN 1995, Johansen) y 277 N en tracción, adoptada igual a la del confirmat.

Variante | Tracción máx.
| (N)

Cortante máx.
| | | (N) | | Tornillo que gobierna: T
/ V (N) | Relación
Proyecto | 317 | 219 | 317 / 182 | 1.28
Con relleno | 96 | 133 | 96 / 109 | 0.49
Relleno + entrepaño | 96 | 133 | 96 / 109 | 0.49
Relleno + entrepaño, cal. 18 | 106 | 137 | 106 / 116 | 0.53

Recomendada: relleno + entrepaño, cal. 14,
pijas a 150 mm | 103 | 139 | 103 / 110 | 0.51

Sin esos tornillos el proyecto empeora (flecha L/89, tablero trasero 1.83, uniones al 183%). Con relleno y fijación rígida las uniones siguen cumpliendo sin ellos (47%), pero la flecha pasa a L/290, por encima del límite L/300, y el apoyo del lateral aire sube de 0.94 a 1.005. Por eso son necesarios: bajan la flecha y la compresión en ese canto.

El contacto entre el PTR y los tableros solo transmite compresión en vertical; en horizontal el modelo base supone una fijación rígida, que hace trabajar juntos al tubo y a los maleteros. La fijación real es con pijas de 4.8 mm a través de la pared del tubo: hacia el piso y los costados de los maleteros y, en las torres, hacia los travesaños superiores. Con la rigidez de EN 1995 (K
ser

= 7401 N/mm por pija) se analizó el tubo cal. 16 y cal. 14 con pijas a cada 150 y 75 mm. Como sensibilidad, con una rigidez cinco veces menor (1500 N/mm, rigidez baja) la fijación cede más, la fuerza en las pijas baja y la flecha sube. Capacidad de diseño de la pija: 283 N en cortante.

Memoria de cálculo estructural. Closet con maleteros sobre PTR de 30 x 30 mm. Revisión 2 | Página 14
Tubo | Fijación | PTR,
| | H1 | Flecha
| | | largo
| | | plazo | Tabl. | Unio. | Torn.
| | | | | | entre
| | | | | | malet. | Pija más
| | | | | | | cargada
| | | | | | | (N) | Pija /
| | | | | | | | cap. | Gobierna
cal. 16 | rígida | 0.40 | L/305 | 0.55 | 0.44 | 0.49 | - | - | idealización
cal. 16 | pijas a 150 mm, EN
| 1995 | 0.41 | L/288 | 0.53 | 0.44 | 0.52 | 680 | 2.40 | pija 2.40
cal. 16 | pijas a 75 mm, EN
| 1995 | 0.41 | L/294 | 0.54 | 0.44 | 0.50 | 504 | 1.78 | pija 1.78
cal. 16 | pijas a 150 mm,
| rigidez baja | 0.42 | L/274 | 0.52 | 0.44 | 0.56 | 261 | 0.92 | flecha 1.09
cal. 16 | sin acción conjunta | 0.42 | L/252 | 0.51 | 0.44 | 0.54 | - | - | flecha 1.19
cal. 14 | pijas a 150 mm, EN
| 1995 | 0.35 | L/322 | 0.53 | 0.44 | 0.48 | 640 | 2.26 | pija 2.26
cal. 14 | pijas a 75 mm, EN
| 1995 | 0.35 | L/328 | 0.54 | 0.44 | 0.47 | 472 | 1.66 | pija 1.66
cal. 14 | pijas a 150 mm,
| rigidez baja | 0.36 | L/307 | 0.52 | 0.44 | 0.51 | 250 | 0.88 | flecha 0.98
cal. 14 | sin acción conjunta | 0.36 | L/282 | 0.51 | 0.44 | 0.49 | - | - | flecha 1.07
Todas las filas llevan relleno y entrepaño. "Gobierna" indica la revisión con la relación más alta.

Con fijación rígida, cada tramo de 150 mm de tubo tendría que transmitir hasta 1848 N en horizontal, varias veces la capacidad de una pija: esa hipótesis no es alcanzable. Con pijas, la fuerza en cada pija y la flecha se mueven en sentido contrario. Con la rigidez de EN 1995 el análisis elástico pide hasta 640 N por pija en cal. 14 a 150 mm (2.26 de la capacidad), y a 75 mm todavía 1.66: la acción conjunta completa no se puede asegurar con pijas en tablero de partículas, a ninguna separación práctica. La pija que se sobrecarga cede por aplastamiento del tablero, que es un modo dúctil, y la fuerza se redistribuye. La variante de rigidez baja es un estado en equilibrio con todas las pijas dentro de su capacidad (88% en cal. 14), y con él la flecha del cal. 14 cumple (L/307). Aun en el caso extremo sin acción conjunta todas las revisiones de resistencia cumplen y la flecha queda en L/282, que excede por poco un criterio de apariencia. El cal. 16 no cumple la flecha con ninguna de estas rigideces.

### 6.7 Apoyo del PTR sobre cantos de tablero

El PTR descansa sobre el canto de 15 mm de los tableros. La reacción de cada tablero es la suma de sus fuerzas de contacto por nodo con 1.35G + 1.5Q, envolvente de rigidez instantánea y final, repartida uniforme en el área de contacto y comparada con fc,d = 2.94 MPa. En los laterales bajo el PTR frontal el área es 15 mm por el solape de 30 mm con el tubo. Bajo el PTR trasero el tubo se arquea sobre la torre y apoya casi todo en la esquina del lateral aire con el tablero trasero; ahí se revisa la esquina en conjunto: el lateral aire en 15 x 15 mm (la otra mitad de la huella cae sobre el trasero) más el trasero en 30 mm de largo. La columna "con suplemento" da la relación con un suplemento de canto: una pieza de 15 mm atornillada a la cara del lateral aire que da al hueco central, a ras de su canto superior, que duplica el ancho de apoyo. De ese lado no interfiere con los travesaños superiores ni con las bisagras de la puerta de la torre.

Apoyo | Variante | Reacción
| | | | | (kN)

Área
(mm²)

σ
(MPa) | Con supl. | σ/fc,d
frente: lateral exterior | Proyecto | 0.54 | 450 | 1.20 | 0.41 | 0.41
frente: lateral aire | Proyecto | 0.88 | 450 | 1.96 | 0.33 | 0.67

fondo: esquina lateral aire y
trasero | Proyecto | 1.24 | 675 | 1.84 | 0.47 | 0.63
frente: lateral exterior | Con relleno | 0.17 | 450 | 0.37 | 0.13 | 0.13
frente: lateral aire | Con relleno | 1.24 | 450 | 2.76 | 0.47 | 0.94

fondo: esquina lateral aire y
trasero | Con relleno | 1.10 | 675 | 1.63 | 0.42 | 0.56

fondo: trasero 15 mm fuera de la
esquina | Con relleno | 0.12 | 8175 | 0.01 | 0.00 | 0.00
frente: lateral exterior | Con relleno, sin tornillos
entre maleteros | 0.07 | 450 | 0.16 | 0.06 | 0.06

Memoria de cálculo estructural. Closet con maleteros sobre PTR de 30 x 30 mm. Revisión 2 | Página 15
Apoyo | Variante | Reacción
(kN)

Área
(mm²)

σ
| | | (MPa) | Con supl. | σ/fc,d
frente: lateral aire | Con relleno, sin tornillos
entre maleteros | 1.33 | 450 | 2.96 | 0.50 | 1.005

fondo: esquina lateral aire y
trasero

Con relleno, sin tornillos
entre maleteros | 1.26 | 675 | 1.87 | 0.48 | 0.63

frente: lateral exterior

Recomendada: relleno +
entrepaño, cal. 14, pijas a
150 mm
0.18 | 450 | 0.39 | 0.13 | 0.13

frente: lateral aire

Recomendada: relleno +
entrepaño, cal. 14, pijas a 150 mm
1.24 | 450 | 2.75 | 0.47 | 0.93

fondo: esquina lateral aire y trasero

Recomendada: relleno +
entrepaño, cal. 14, pijas a 150 mm
1.23 | 675 | 1.82 | 0.46 | 0.62

Con relleno el canto del lateral aire queda al 94% de la resistencia de diseño; sin tornillos entre maleteros llega al 100.5%, ligeramente por encima. En la esquina trasera el trasero recibe 0.66 de sus 0.78 kN dentro de 30 mm del lateral aire. Con el suplemento de canto la relación más alta baja a 0.50. El suplemento no puede fijarse con confirmat, que no cabe en dos tableros de 15 mm; se fija con tornillos pasantes M6 con casquillo, de 314 N de capacidad de diseño en cortante cada uno. Bajo el PTR frontal el suplemento entrega al lateral aire hasta 0.67 kN, que piden 3 tornillos junto a ese extremo; bajo el trasero, 0.31 kN y 2 tornillos.

### 6.8 Estabilidad de laterales

Se repitió el análisis con no linealidad geométrica (cascarones ASDShellQ4 corrotacionales y PTR corrotacional). La combinación se incrementa por un factor λ con una pequeña perturbación lateral en el canto libre de cada lateral. Se mide el abombamiento de los laterales respecto al plano de sus esquinas.

Caso | Abombamiento a
| λ = 1 (mm) | Pieza que
| | gobierna | λcr de
| | | Southwell
| | | (referencia) | Pendiente
| | | | final / inicial | Factor de carga
| | | | | límite λ
proyecto, ELU con E/γM | 18.69 | Lateral exterior | 5.9 | 3.5 | > 3.156
proyecto, largo plazo E_fin | 34.71 | Lateral exterior | 3.0 | 3.9 | > 1.75
con relleno, ELU con E/γM | 1.39 | Lateral aire | 2.6 | 15.6 | > 2.031
con relleno, largo plazo E_fin | 3.90 | Lateral aire | 1.7 | 18.6 | > 1.406

relleno y entrepaño, ELU con
E/γM | 0.33 | Lateral exterior | 18.6 | 1.5 | > 4.0

relleno y entrepaño, largo
plazo E_fin | 1.26 | Lateral exterior | 13.8 | 1.6 | > 3.125

El factor de carga límite es el intervalo entre el último paso convergido y el menor incremento que ya no converge (antes de detenerse se reintenta con pasos de 1/4 y 1/16 del paso base de 0.5 y con otros algoritmos). Cada corrida tiene un tope de 50 a 60 minutos de cálculo; las marcadas con ">" se detuvieron por ese tope o al llegar a λ = 4 y el valor es una cota inferior. En el proyecto y en la variante con relleno solo, al detenerse ya avanzaban con el paso mínimo (Δλ = 1/32) y con la pendiente varias veces mayor que al inicio: están cerca de su límite. La pendiente final / inicial compara cómo crece el abombamiento de los laterales al final y al principio de la corrida: cerca de 1 el comportamiento es lineal y muy por encima de 1 la rigidez se está perdiendo. La recta de Southwell se da solo como referencia. Criterios: con λ de 3 o más se considera holgado, entre 1.5 y 3 al límite y por debajo de 1.5 no cumple; además, el abombamiento con la carga sostenida no debe pasar de L/300 del tramo libre (2.9 mm), para que el lateral no se vea pandeado con el tiempo.

En el proyecto la corrida a corto plazo llega a λ = 3.156, pero eso no indica una reserva real: el lateral exterior ya se abomba 18.7 mm a λ = 1 y 104 mm al final de la corrida. No hay un pandeo súbito sino una flexión fuera del plano que crece con la carga, y el tablero se agota antes por resistencia (índice 1.03 del lateral exterior en el análisis lineal, sección
6.4) y por la deformación diferida.

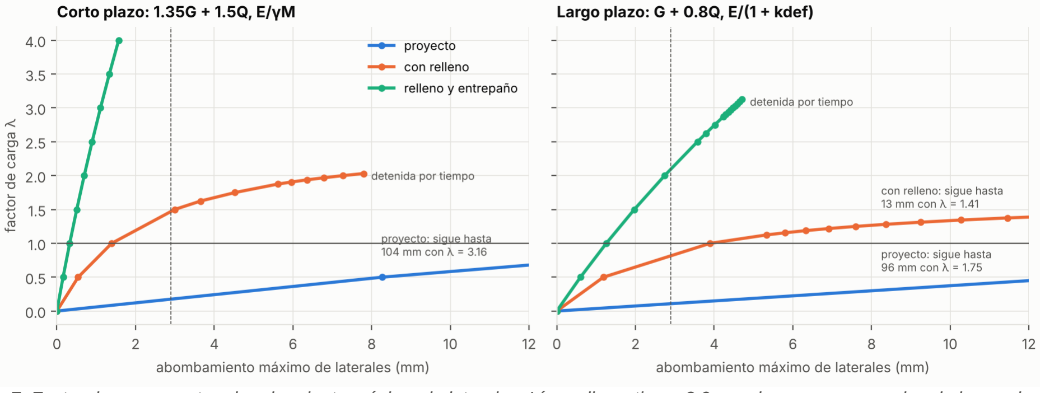
[picture p7: figure]
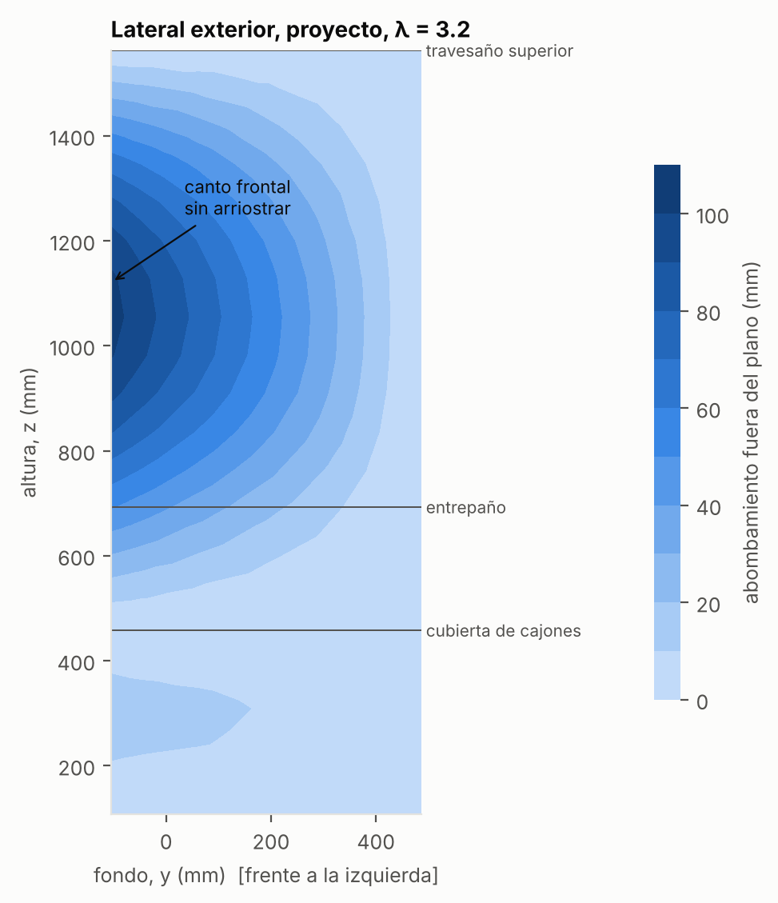
[picture p8: figure]

Memoria de cálculo estructural. Closet con maleteros sobre PTR de 30 x 30 mm. Revisión 2 | Página 16

Figura 7. Factor de carga contra abombamiento máximo de laterales. Línea discontinua: 2.9 mm; las curvas que salen de la escala se indican con su último punto.

Figura 8. Abombamiento del lateral exterior izquierdo en el último paso convergido del proyecto a corto plazo: se concentra en el canto frontal libre.

### 6.9 Volteo y anclaje al muro

Con G + ψ2

Q, barra incluida, el centro de masa queda a 1112 mm de altura y 238 mm detrás de la cara frontal del zócalo; vacío, a 1277 mm y 226 mm. Sin anclaje, la aceleración horizontal que inicia el volteo es 0.18 g con el mueble vacío y 0.21 g cargado. Con H = 0.5(G + ψ2

Q) = 3.78 kN el factor de seguridad sin anclaje sería 0.43. Fuerzas en anclajes del modelo con taquetes en la parte alta trasera:
Ubicación del anclaje | Altura (mm) | Fuerza (kN)
lateral exterior torre izq. | 1490 | 0.93
lateral exterior torre der. | 1490 | 0.93
tira trasera de maletero, x = 7 mm | 2378 | 0.14

Memoria de cálculo estructural. Closet con maleteros sobre PTR de 30 x 30 mm. Revisión 2 | Página 17
Ubicación del anclaje | Altura (mm) | Fuerza (kN)
tira trasera de maletero, x = 953 mm | 2378 | 0.22
tira trasera de maletero, x = 968 mm | 2378 | 0.18
tira trasera de maletero, x = 1913 mm | 2378 | 0.18
tira trasera de maletero, x = 1928 mm | 2378 | 0.22
tira trasera de maletero, x = 2873 mm | 2378 | 0.14

Memoria de cálculo estructural. Closet con maleteros sobre PTR de 30 x 30 mm. Revisión 2 | Página 18

## 7. Conclusiones y recomendaciones

- Con el PTR de 30 x 30 mm el mueble, tal como está diseñado, no cumple: la flecha del conjunto, las uniones y el

tablero trasero de las torres quedan fuera de criterio, y los laterales exteriores se pandean con la carga sostenida. El calibre del tubo no cambia esa conclusión, porque lo que falla es el apoyo del tubo en el lateral aire.
- Colocar un relleno de melamina de 15 mm (585 x 205 mm) bajo el canto inferior de cada lateral aire, entre la

cubierta de cajones (z 465) y el lateral aire (z 670), confirmado a la cubierta y al trasero. Así el lateral aire apoya en compresión directa hasta el piso. Alternativa equivalente: un lateral interior de una pieza de 585 x 1455 mm.
- Usar PTR de 30 x 30 mm cal. 14 (1.9 mm) fijado con pijas de 4.8 mm a cada 150 mm al piso de los maleteros y a

los travesaños superiores de las torres. Con relleno y entrepaño cumple la resistencia y la flecha (L/307 a L/322 según la rigidez real de las pijas). El cal. 16 y el cal. 18 no cumplen la flecha del tramo central.
- Agregar un entrepaño fijo intermedio (590 x 585 x 15 mm, a unos 1120 mm del piso) en el compartimento superior

de cada torre, confirmado a los dos laterales y al trasero con separación máxima de 150 mm. Arriostra el canto frontal de los laterales, que controla la estabilidad. Si se prefiere no perder el espacio, la alternativa es un poste metálico (PTR de 1" o ángulo de 1 1/2") en cada esquina frontal de la torre, desde el piso hasta el PTR, que no se analiza en esta memoria y requiere su propio cálculo.
- Colocar un suplemento de canto en cada lateral aire: una pieza de melamina de 15 mm de unos 585 x 100 mm en

la cara del lateral aire que da al hueco central, a ras de su canto superior, fijada con tornillos pasantes M6 con casquillo (los de la sección 6.7, junto a cada PTR), para que el tubo apoye en 30 mm de ancho en lugar de 15 mm.
- Atornillar los maleteros entre sí con cuatro tornillos pasantes de unión de módulos (M6 con casquillo) por costado

común, cerca de las esquinas.
- Anclar al muro: dos taquetes en la parte alta trasera de cada torre y dos por maletero, con capacidad de diseño en

tracción no menor que las fuerzas de la sección 6.9. El anclaje también es necesario para limitar el desplome en servicio.
- Si no se coloca el relleno, no basta con atornillar más: las uniones del tablero trasero necesitarían confirmat a cada

60 mm o menos y aun así la flecha y el pandeo de laterales no cumplen.
- Repisas: con contenidos pesados permanentes conviene un piso de maletero de 20 mm o más y un refuerzo frontal en

los entrepaños de torre, para limitar la flecha diferida.

## 8. Supuestos que conviene confirmar

- Calibre del tubo de 30 x 30 mm: el del proyecto no se conoce; se usó cal. 16 (1.52 mm) como base, se revisaron cal.

18 y cal. 14 y se recomienda cal. 14. Grado del acero: se adoptó F
y

= 250 MPa.
- Posición de los PTR (a paño frontal y trasero, longitud completa de 2880 mm) y que los maleteros se elevan 30 mm

sobre las torres. La altura total pasa de 2440 a 2470 mm. El archivo incluye un elemento de referencia de 2480 mm de altura detrás del mueble que podría ser el muro o el plafón del nicho: la holgura quedaría en unos 10 mm.
- Tornillos pasantes M6 entre maleteros y en el suplemento, y pijas de 4.8 mm del PTR: capacidad en cortante y rigidez

calculadas con EN 1995 para tablero de partículas de 680 kg/m³; la tracción del tornillo M6 se tomó igual a la del confirmat. La fuerza en las pijas crece con su rigidez real, que conviene confirmar.
- Calidad del tablero y del conector: los valores de resistencia son adoptados para melamina de partículas de uso interior

y deben confirmarse con el proveedor.
- Existencia de la barra de colgar en el hueco central: se incluyó en todas las combinaciones, del lado conservador para

resistencia y anclaje.
- Coeficiente horizontal para anclaje (0.5); debe ajustarse al sitio con la normativa local aplicable.

Memoria de cálculo estructural. Closet con maleteros sobre PTR de 30 x 30 mm. Revisión 2 | Página 19

## 9. Reproducibilidad

Todo el cálculo está en el repositorio: herramientas/skp_lector.py extrae la geometría del .skp, modelo/modelo_fe.py arma el modelo, modelo/ejecutar.py corre variantes y combinaciones, modelo/verificaciones.py hace las revisiones, modelo/pandeo.py el análisis no lineal y modelo/figuras.py y modelo/memoria.py generan figuras y este documento. El perfil se define en modelo/parametros.py. Resultados numéricos completos en resultados/resultados.json y resultados/verificaciones.json.
