mpedromogollon-source/muebles/resultados/figuras/fig06_pandeo.png

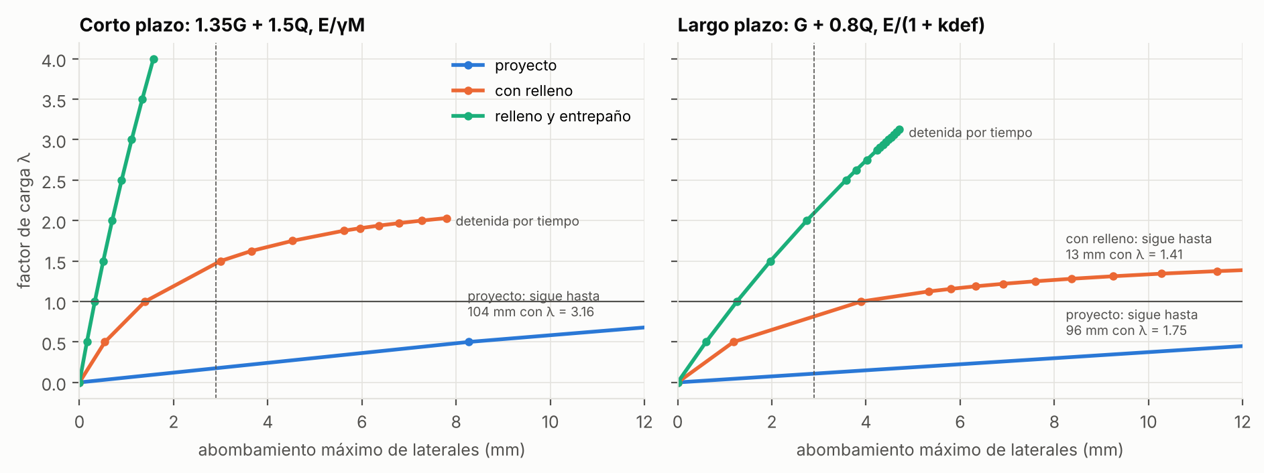
resultados/figuras/fig06_pandeo.png
