mpedromogollon-source/muebles/(commit log)

2026-10-12 Agregar modelo FE y memoria de cálculo del closet con PTR 3x3
    Lector del formato SketchUp 2023 que extrae la geometría real del
    closet (89 piezas, igual al diagrama de corte) y modelo 3D en
    OpenSeesPy: tableros como cascarones, PTR como vigas, uniones
    semirrígidas con apoyo a compresión y contacto unilateral PTR-mueble.
    Incluye combinaciones AISC 360-16 y EN 1995, variantes con relleno
    bajo el lateral aire y entrepaño fijo intermedio, análisis con no
    linealidad geométrica, anclaje al muro, figuras y memoria en PDF.
    Claude-Session: https://claude.ai/code/session_01BLzfT3avf7BBiFDBV4UvRa
    [closet_pedido_mx.skp]
2026-10-12 Recalcular con PTR de 30 x 30 mm (revisión 2, en curso)
    El cliente aclaró que el PTR es de 3 x 3 cm, no de 3" x 3". Se
    reparametrizó el perfil (cal. 18, 16 y 14 con espesor de diseño
    0.93 t), se recalcularon todas las variantes y se reescribió la
    memoria. Falta incorporar el análisis de pandeo final, que sigue
    corriendo, y las correcciones de la auditoría.
    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
2026-10-12 Pandeo con reintentos y textos de estabilidad y apoyo revisados
    El barrido no lineal reintenta cada incremento con pasos de 1/4 y
    1/16 y con otros algoritmos antes de declarar pérdida de
    convergencia, y registra el tablero vertical con mayor
    abombamiento. La memoria explica los criterios de estabilidad,
    cuantifica la solera de reparto bajo el PTR y aclara el alcance de
    la variante sin tornillos entre maleteros.
    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
2026-10-12 Corregir hallazgos de la auditoría independiente
    - Flecha del PTR revisada también en el tramo central (L = 1655 mm).
    - Comprobación manual como viga continua sobre los cuatro laterales.
    - Estado último del PTR también con la rigidez final de la melamina.
    - Tornillos entre maleteros a tracción, tornillo por tornillo.
    - Fijación PTR-tablero con pijas como variante realista; la solución
    recomendada pasa a tubo cal. 14 con pijas a cada 150 mm.
    - Apoyo del PTR con fuerzas por nodo y revisión de la esquina trasera;
    suplemento de canto en lugar de la solera.
    - Barra de colgar incluida en anclaje y volteo; volteo con mueble vacío.
    - Peso del PTR con espesor nominal; desplome diferido;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
2026-10-12 Aplicar la segunda ronda de verificación (código)
    Uniones entre tableros con kdef duplicado a largo plazo (EN 1995
    2.3.2.2), pijas con rigidez y capacidad de EN 1995, axial del PTR con
    interacción H1, envolvente de rigidez instantánea y final en apoyo,
    tornillos, uniones, tableros y fijación, pijas de torre incluidas,
    suplemento de canto con tornillos pasantes M6 y elección automática de
    la configuración recomendada. Los resultados se regeneran al terminar
    las corridas.
    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
2026-10-12 Resultados finales de la revisión 2 y memoria actualizada
    Corridas completas con kdef duplicado en uniones a largo plazo, pijas
    con rigidez de EN 1995, rigidez baja y sin acción conjunta. La
    solución recomendada es tubo cal. 14 con pijas a cada 150 mm: cumple
    la flecha del tramo central entre L/307 y L/322 según la rigidez real
    de las pijas, y todas las revisiones de resistencia aun sin acción
    conjunta.
    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
2026-10-12 Aplicar la revisión final de la memoria
    Flecha de la variante sin tornillos marcada como fuera de criterio,
    reparto con uniones rígidas en los dos PTR, pendiente de estabilidad
    calculada sobre los laterales, unidades de los pasos de carga,
    encabezados de tablas y columna que indica la revisión que gobierna en
    la tabla de fijación.
    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
